ahtraddis/cerealometer-hardware/images/hardware/hx711/51C13mj0NpL._SL1000_.jpg

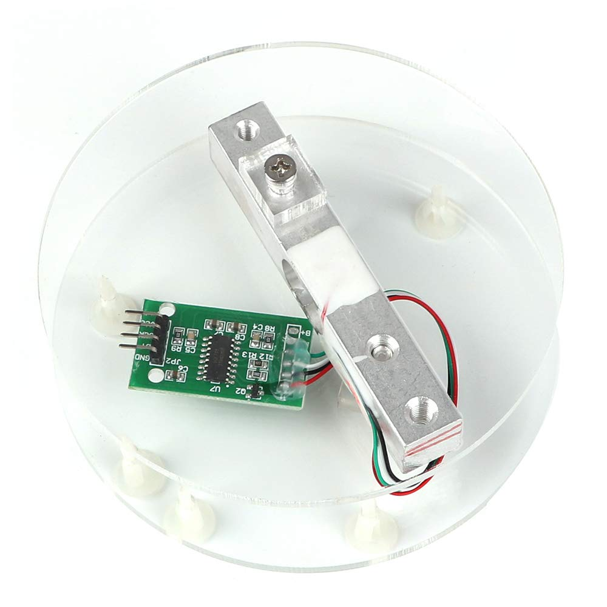
images/hardware/hx711/51C13mj0NpL._SL1000_.jpg
