ahtraddis/cerealometer-hardware/images/hardware/hx711/61TM5gzSDYL._SL1000_.jpg

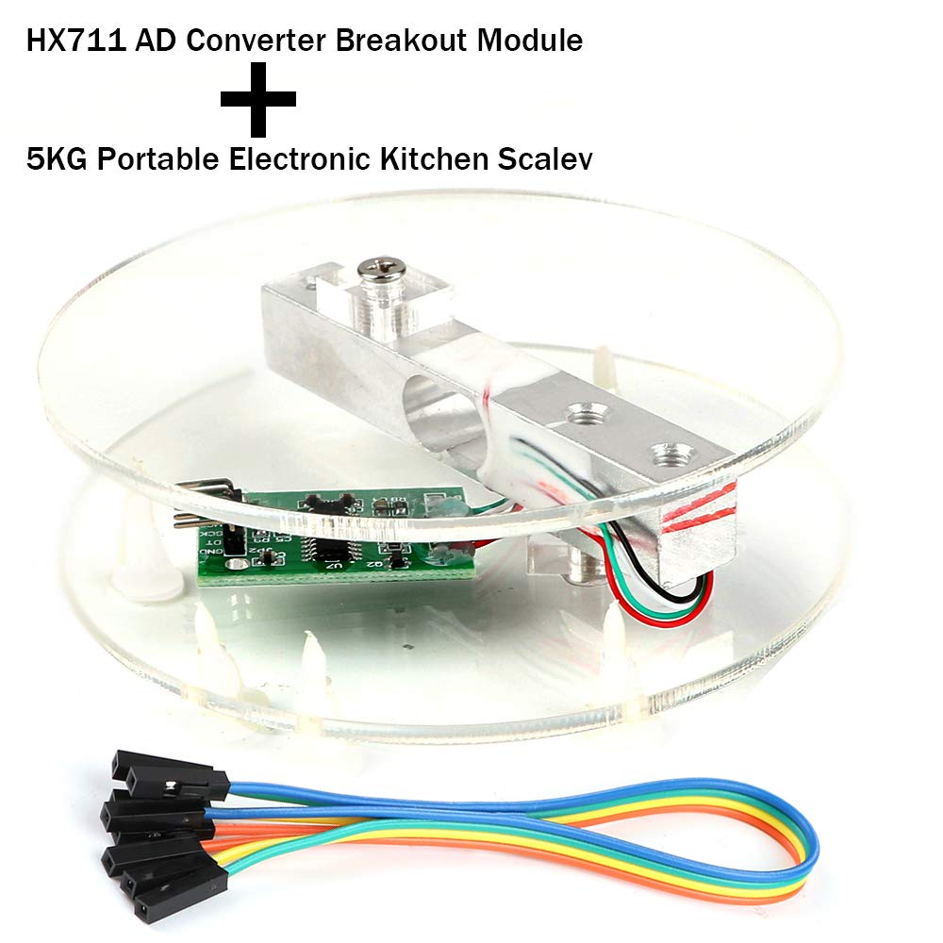
images/hardware/hx711/61TM5gzSDYL._SL1000_.jpg
