ahtraddis/cerealometer-hardware/images/hardware/hx711/61zEpExsuuL._SL1000_.jpg

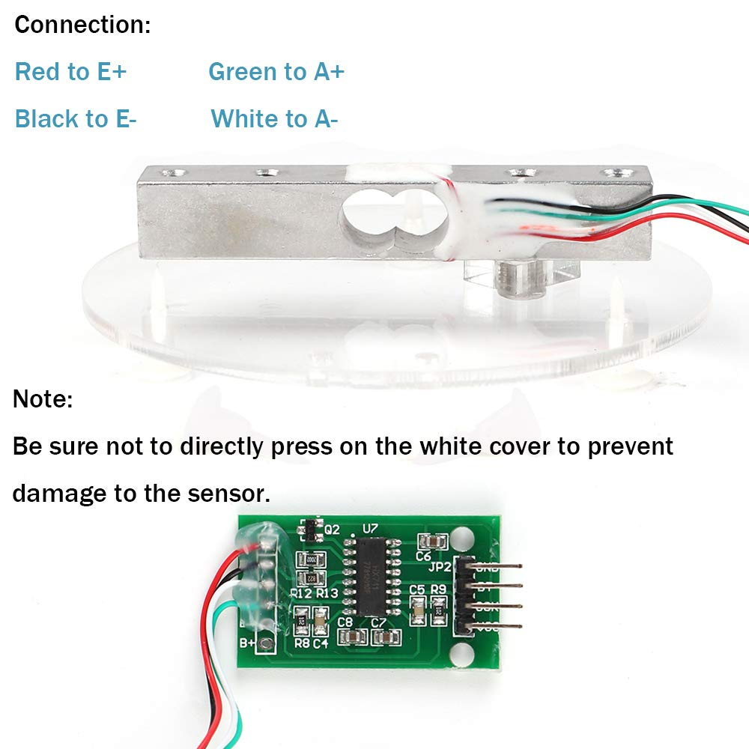
images/hardware/hx711/61zEpExsuuL._SL1000_.jpg
