ahtraddis/cerealometer-hardware/tests/README.md

## Test Sketches
This directory contains tests or code excerpts as standalone Arduino sketches.

To upload one of these to a board, change the 'sketch' parameter in your /.vscode/arduino.json file.
