ahtraddis/cerealometer-hardware/images/hardware/SchwartzLab-Cerealometer-v1.pdf

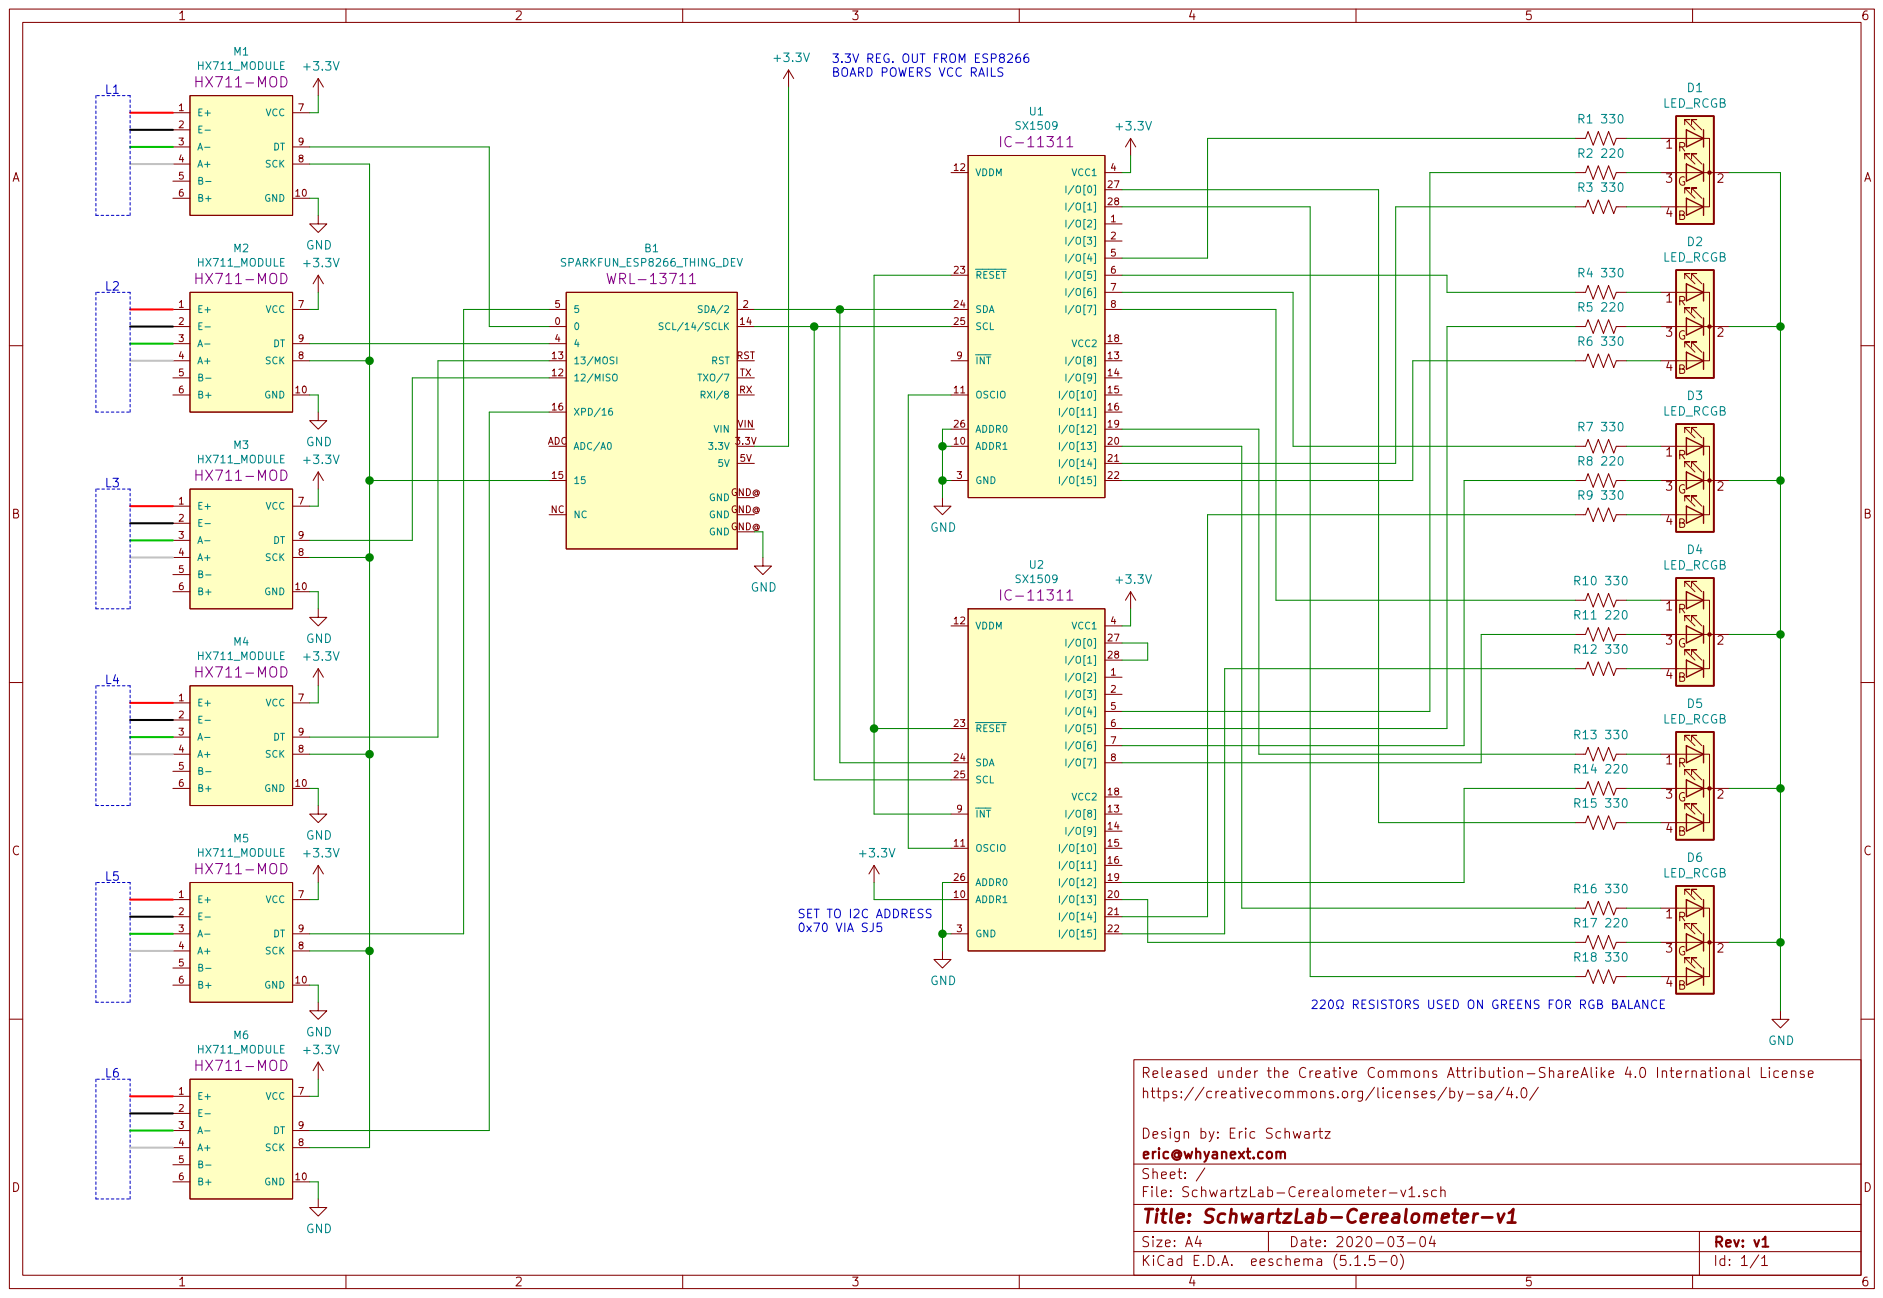
[picture p18: page 1]

3.3V REG. OUT FROM ESP8266 BOARD POWERS VCC RAILS

220 RESISTORS USED ON GREENS FOR RGB BALANCE

Design by: Eric Schwartz
File: SchwartzLab-Cerealometer-v1.sch Sheet: / eric@whyanext.com

Id: 1/1 Title: SchwartzLab-Cerealometer-v1
