ahtraddis/cerealometer-hardware/(commit log)

2020-02-18 removed SHA1_FINGERPRINT config param
    fixed off-by-one error in PORT_COUNT conditional
    [cerealometer.ino]
2020-02-27 substituted HX711 lib for HX711-multi to use common clock signals note: GPIO15 requires special handling due to boot process (see notes) removed code associated with MAX7219, now using SX1509 I/O exp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
2020-02-29 added LEN macro added hardcoded tare offsets and cleaned up calibration factor logic; removed HX711 lib tare() calls added serial commands for various LED tests incl. data toggling implemented/reimpl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
2020-03-01 added EEPROM read/write support removed hardcoded tare offsets and calibration factors, now storing/retrieving from EEPROM WIP moving device_id and WiFi credentials to EEPROM implemented calibration 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
2020-03-04 moved HTML raw strings to templates.h; added HTML output functions and token replacement added HTTP handler functions: handleRoot, handleSettings, handleCalibrate, handleUtil, handleLoading added LED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
    [cerealometer.ino, templates.h]
2020-03-10 documented constants reimplemented statusToLedState() as a static array STATUS_TO_LED_STATE[] reimplemented statusToString() as a const array STATUS_TO_STRING[] added macros for common uses like RDEV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
    [cerealometer.ino, debug.h, templates.h]
